radrajith/ESE-495_Laser_arduino/pcb_layout_ESE495.docx

Schematic

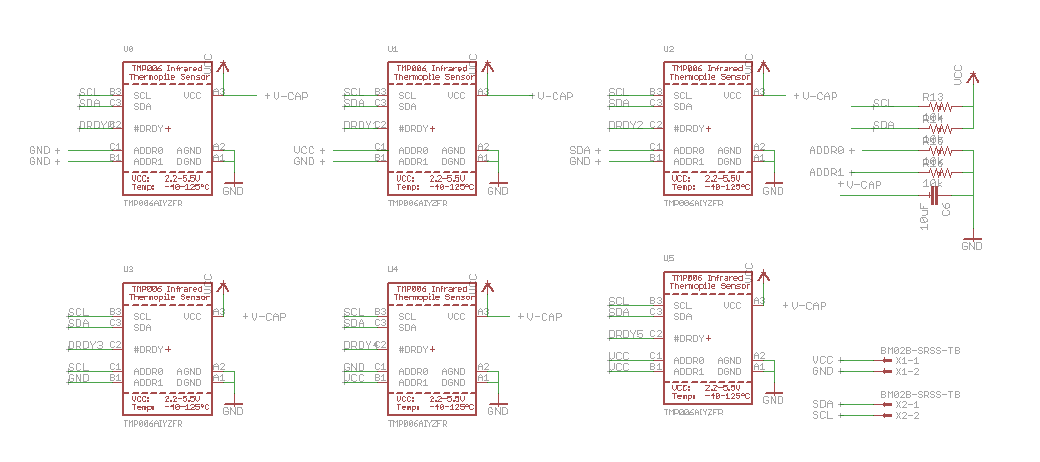
[picture p18: figure]

Front back

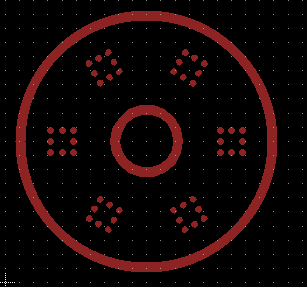
[picture p19: figure]
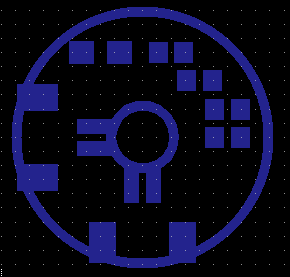
[picture p20: figure]
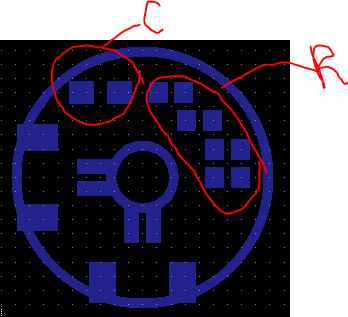
[picture p21: figure]

Outer Diameter – 0.450 inches or 11.43 mm

Inner diameter – 0.1 inches or 2.54mm

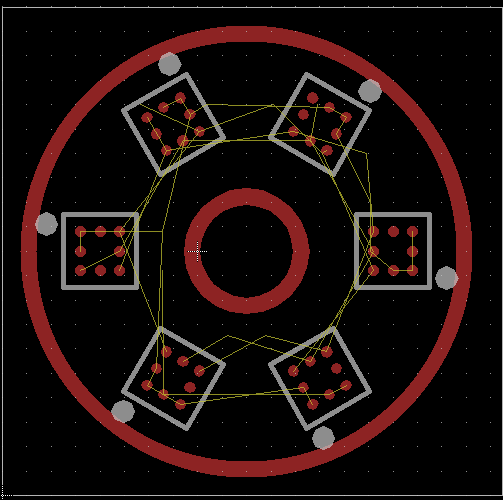
[picture p22: figure]
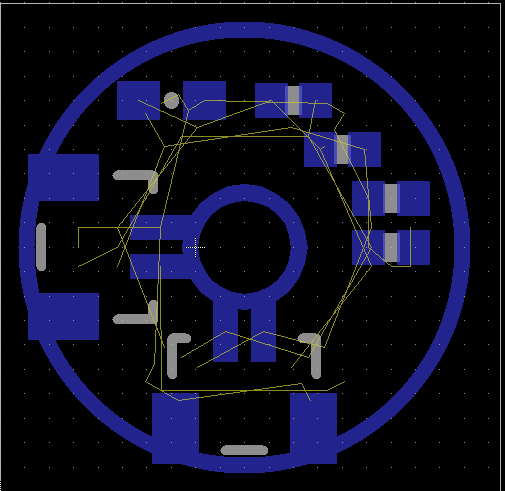
[picture p23: figure]
