radrajith/ESE-495_Laser_arduino/circuit simulations.docx

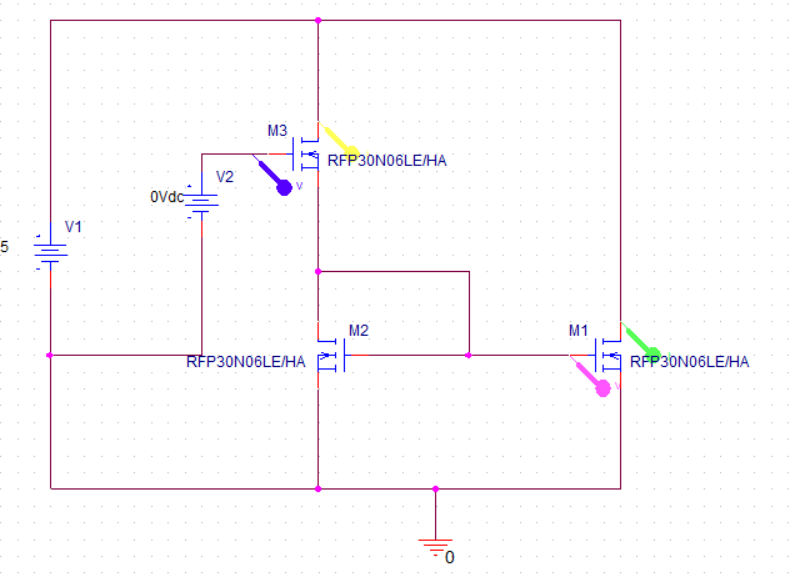
[picture p49: figure]
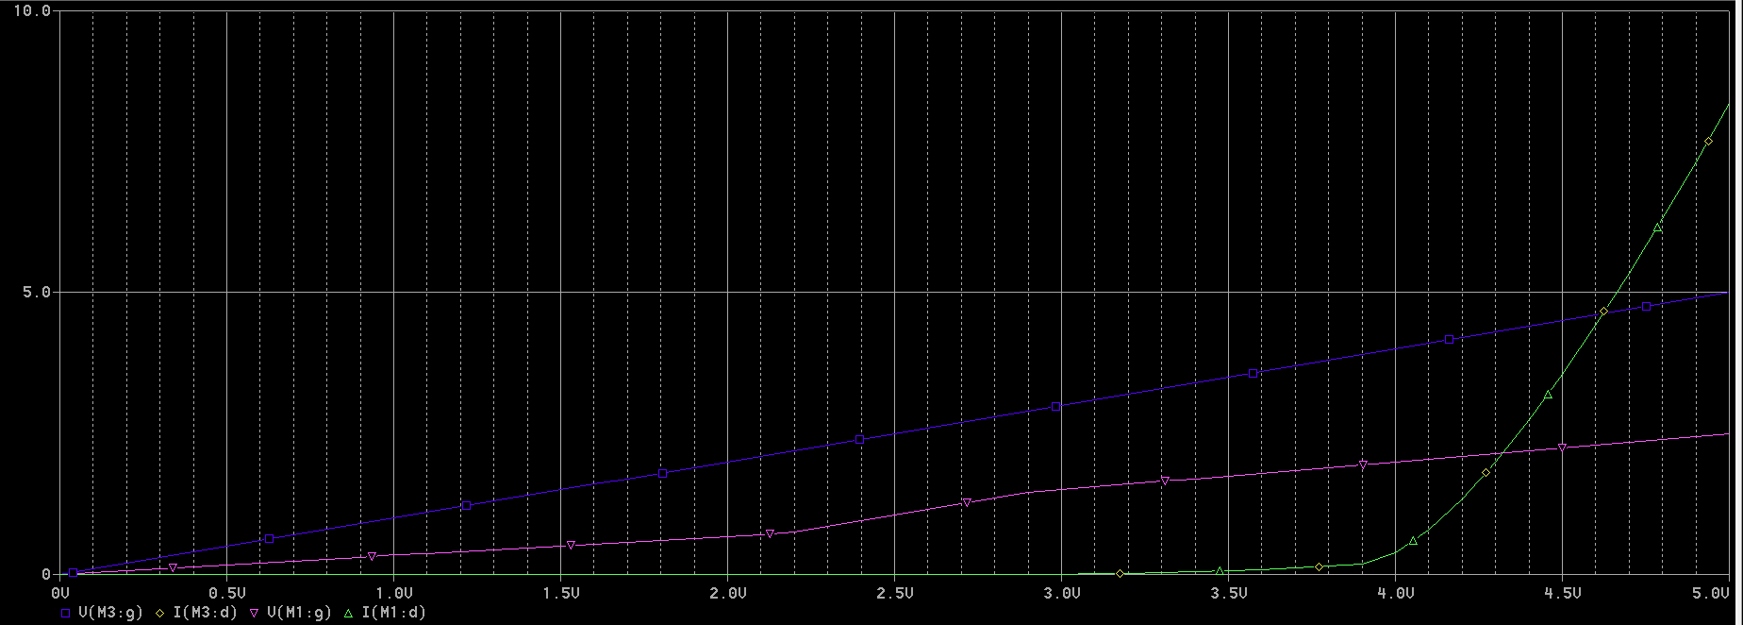
[picture p50: figure]
