radrajith/ESE-495_Laser_arduino/absoption spectra of different skin constituents.png

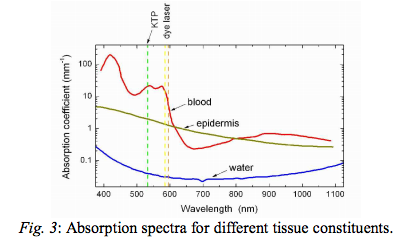
absoption spectra of different skin constituents.png
