radrajith/ESE-495_Laser_arduino/laser PS simulations/linear schemati.PNG

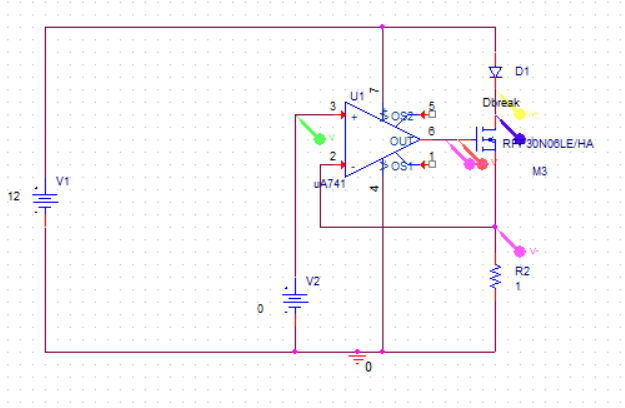
laser PS simulations/linear schemati.PNG
