radrajith/ESE-495_Laser_arduino/laser PS simulations/linear sim.PNG

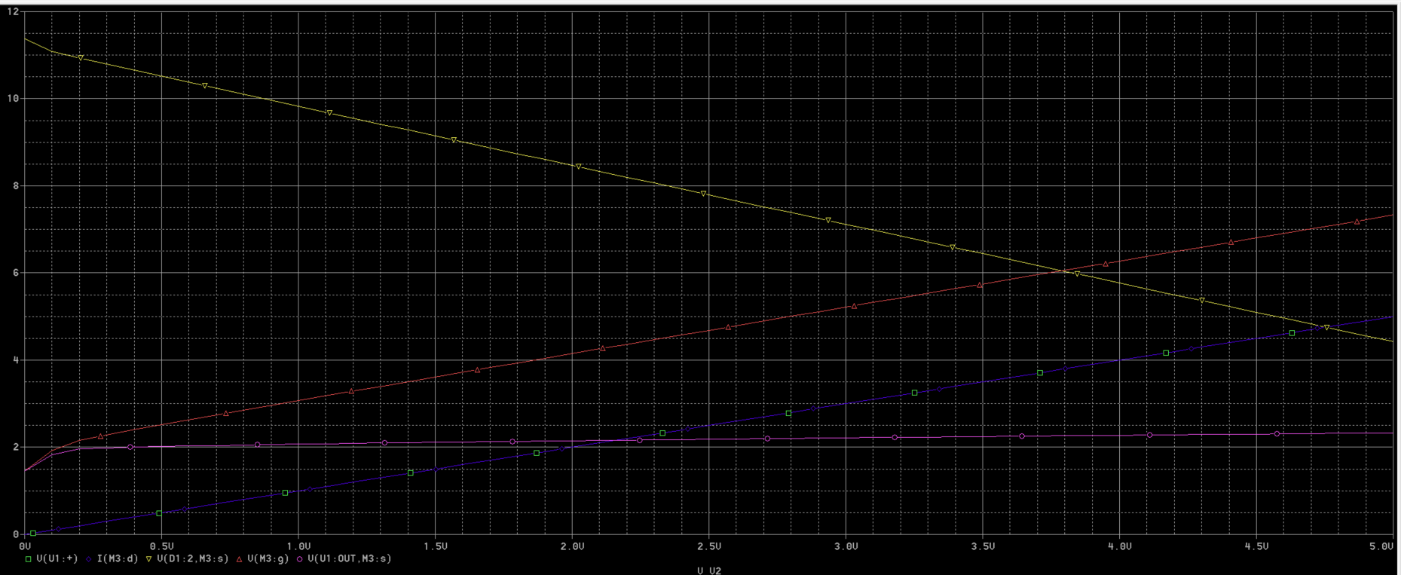
laser PS simulations/linear sim.PNG
