radrajith/ESE-495_Laser_arduino/laser PS simulations/sine wave schematic.PNG

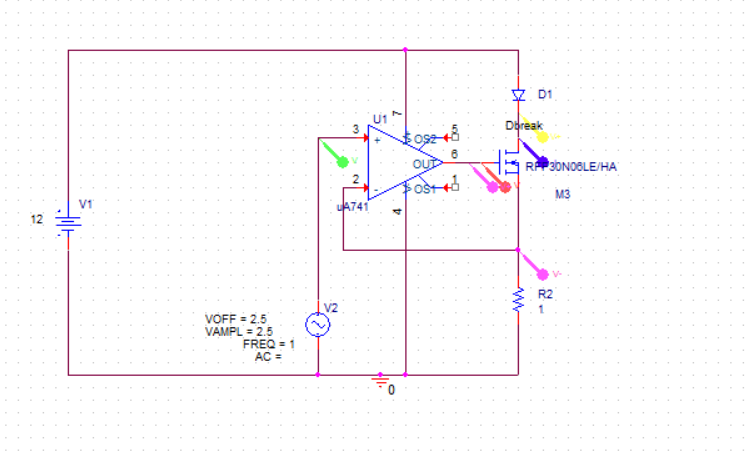
laser PS simulations/sine wave schematic.PNG
