radrajith/ESE-495_Laser_arduino/laser PS simulations/sine wave.PNG

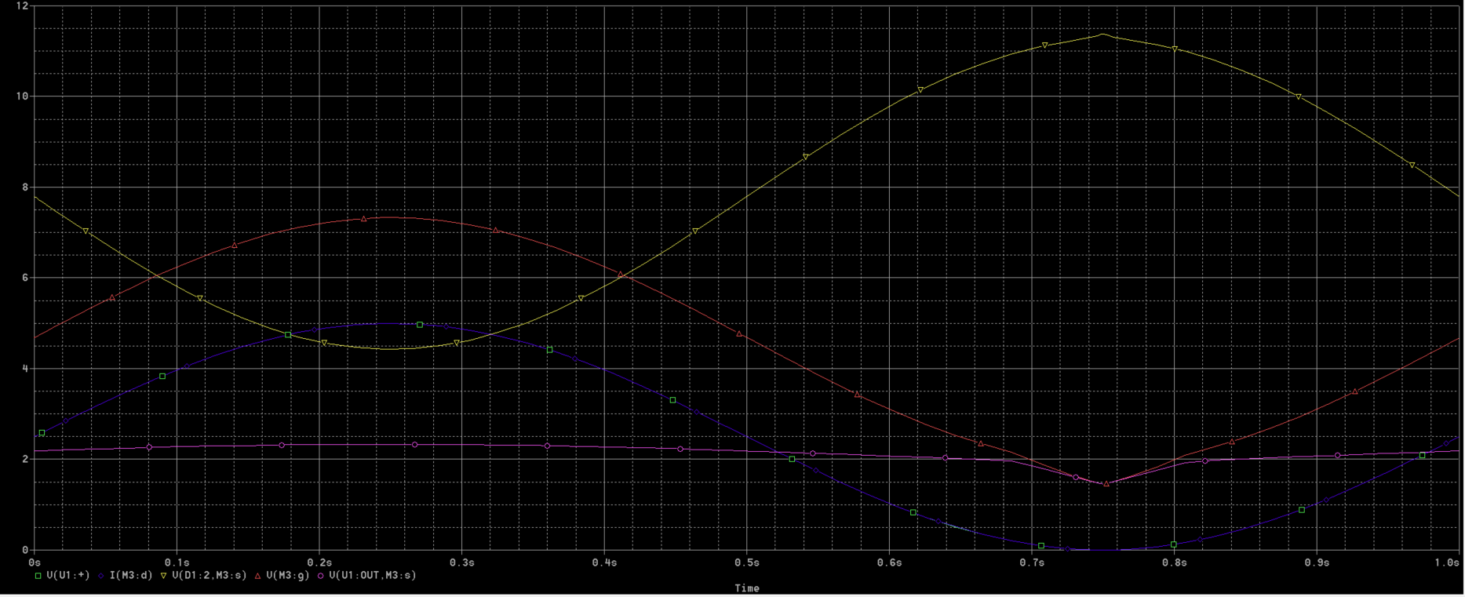
laser PS simulations/sine wave.PNG
