radrajith/ESE-495_Laser_arduino/(list of files, cad)

Other CAD files:
object image.dwg
