radrajith/ESE-495_Laser_arduino/Pspice model/test1.pdf

Date/Time run: 01/13/17 20:32:57

** Profile: "SCHEMATIC1-test1" | [ c:\users\radra\box sync\senior fall 2016\ese 440\circuit simulation 1\... Temperature: 27.0

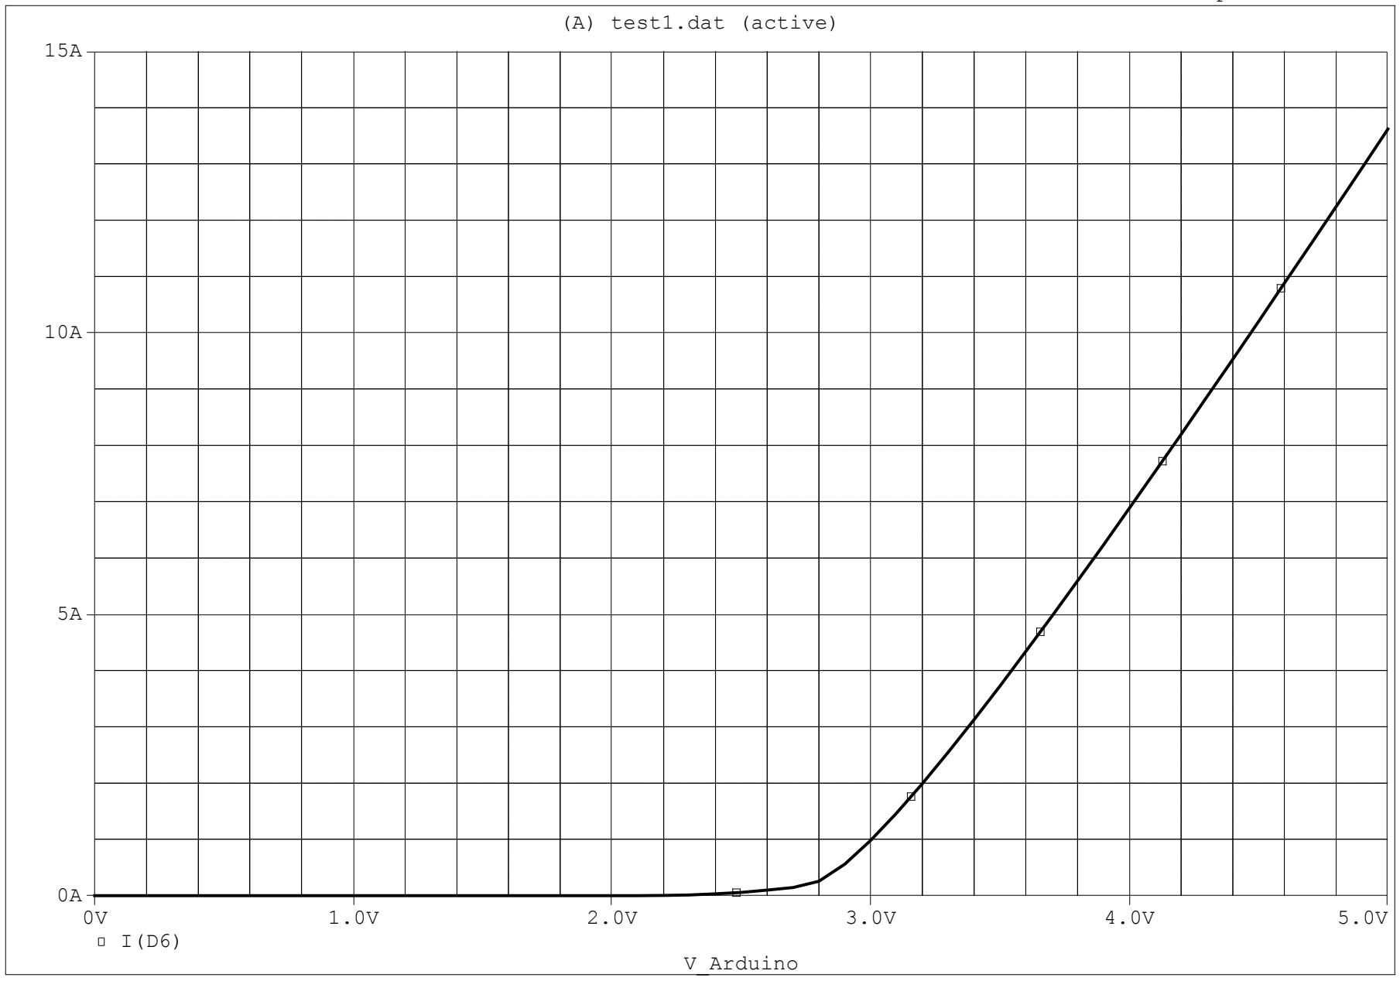
[picture p56: figure]
(A) test1.dat (active); V_Arduino

Date: January 13, 2017 | Page 1 | Time: 20:34:19
