radrajith/ESE-495_Laser_arduino/ESE 499 laser characteristics.xlsx

Sheet: Sheet1
Voltage (mV) | Current (mA) | Power(mW) | Actual voltage(mV) | Voltage across Vds
0 | 0 | 0
1664 | 100 | 0.11 | 1586
1787 | 200 | 0.24 | 1630
1898 | 300 | 0.41 | 1664
2000 | 400 | 0.63 | 1692
2115 | 500 | 0.97 | 1717
2233 | 600 | 1.44 | 1740 |  |  |  | 1 | 1
2338 | 700 | 2.21 | 1762 |  |  |  | 2 | 1.644
2443 | 800 | 4.01 | 1781 |  |  |  | 3 | 1.74
2536 | 900 | 32 | 1800 |  |  |  | 3.5 | 1.768 | Resistance | 0.943K
2598 | 950 | 90.1 |  |  |  |  | 3.995 | 1.793
2613 | 960 | 97
2625 | 970 | 118
2633 | 980 | 123 |  |  | Resistance (ohms)
2636 | 990 | 134 |  |  | 1.36
2643 | 1000 | 152.2 | 1821
2655 | 1010 | 159.5
2666 | 1020 | 183.4
2670 | 1030 | 184.6
2682 | 1040 | 193.2 |  |  | 1.9W max
2695 | 1050 | 200
2700 | 1060 | 243.8
2820 | 1070 | 250.6
2850 | 1080 | 267
2880 | 1090 | 276.3
2900 | 1100 | 303.3 | 1841 | 0.074
2910 | 1110 | 305
2930 | 1120 | 311.7
2950 | 1130 | 336
2960 | 1140 | 346.4
2970 | 1150 | 359.3
3040 | 1200 | 424.9 | 1860
3100 | 1250 | 483.6
3170 | 1300 | 548.1 | 1879
3226 | 1350 | 607.2
3289 | 1400 | 677.8 | 1898
3410 | 1450 | 763.4
3460 | 1500 | 824.2 | 1917
3540 | 1550 | 887.9
3630 | 1600 | 954.2 | 1936
3689 | 1650 | 1007
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
