radrajith/ESE-495_Laser_arduino/laser_test_circuit.jpg

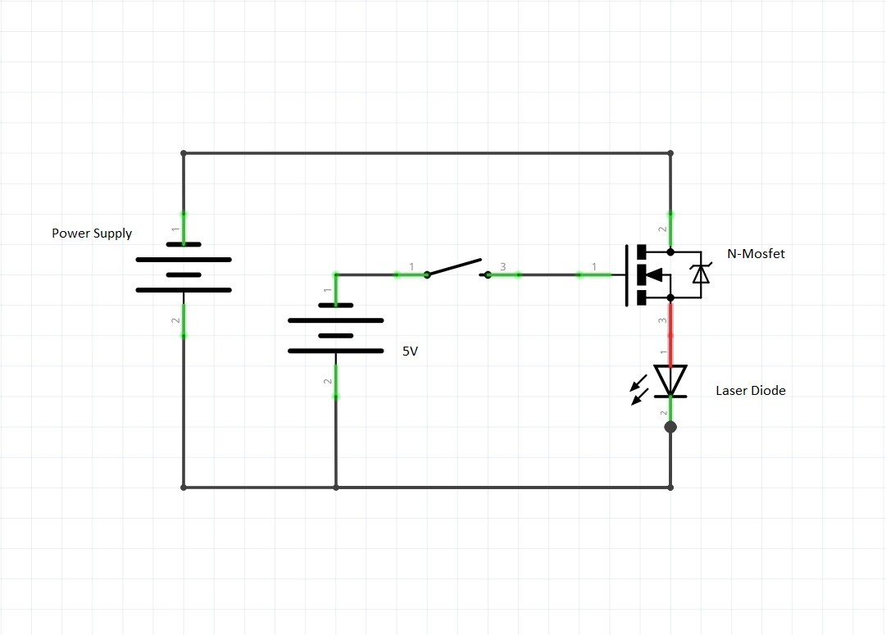
laser_test_circuit.jpg
