radrajith/ESE-495_Laser_arduino/Pspice model/test3.pdf

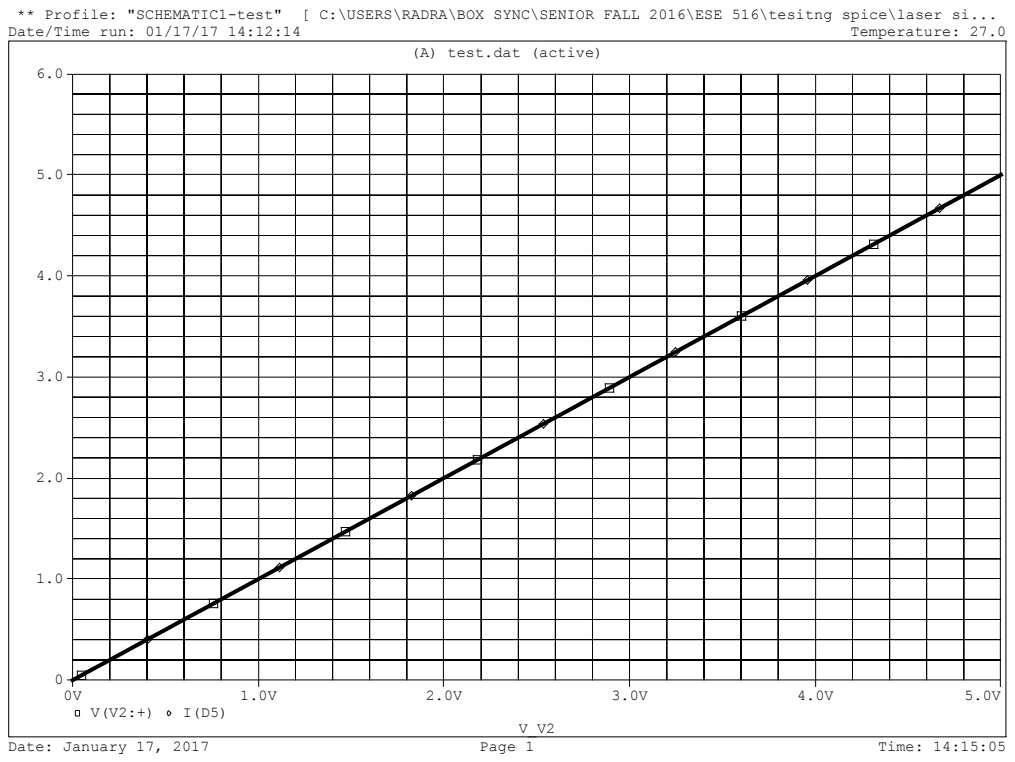
[picture p58: page 1]
** Profile: "SCHEMATIC1-test"; [ C:\USERS\RADRA\BOX SYNC\SENIOR FALL 2016\ESE 516\tesitng spice\laser si...; Temperature: 27.0; Date: January 17, 2017; Page 1; Time: 14:15:05

Date/Time run: 01/17/17 14:12:14

(A) test.dat (active)
