radrajith/ESE-495_Laser_arduino/Pspice model/test.pdf

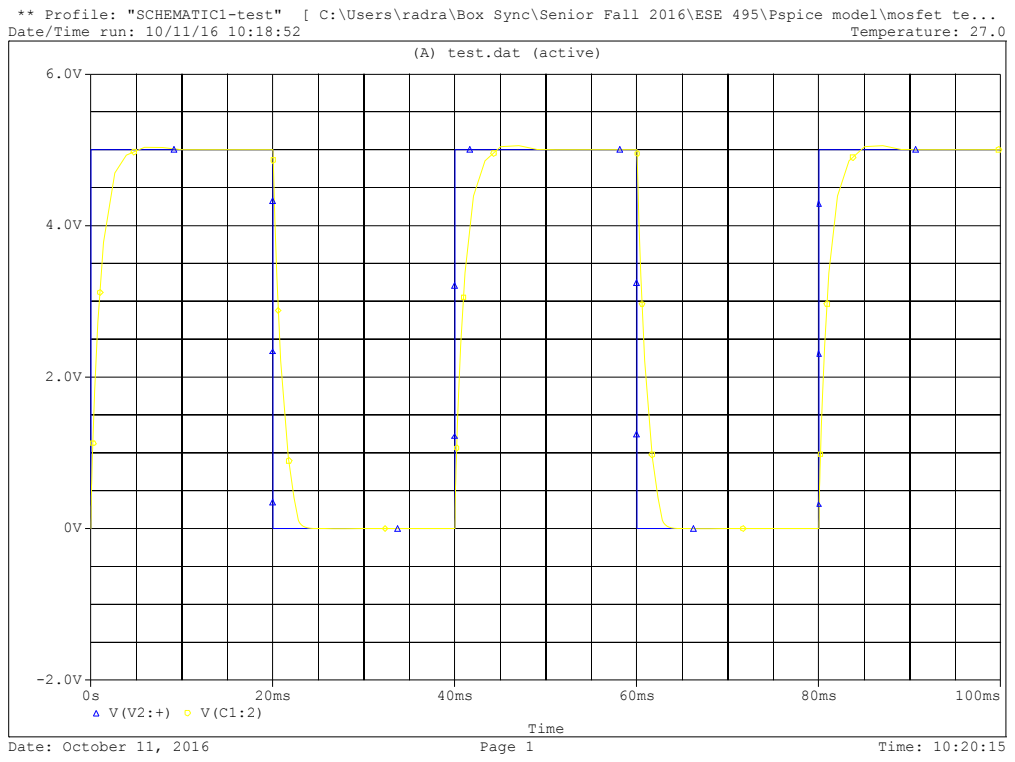
[picture p59: page 1]
** Profile: "SCHEMATIC1-test"; [ C:\Users\radra\Box Sync\Senior Fall 2016\ESE 495\Pspice model\mosfet te...; Temperature: 27.0; Date: October 11, 2016; Page 1; Time: 10:20:15; Time

Date/Time run: 10/11/16 10:18:52

(A) test.dat (active)
