radrajith/ESE-495_Laser_arduino/object image.pdf

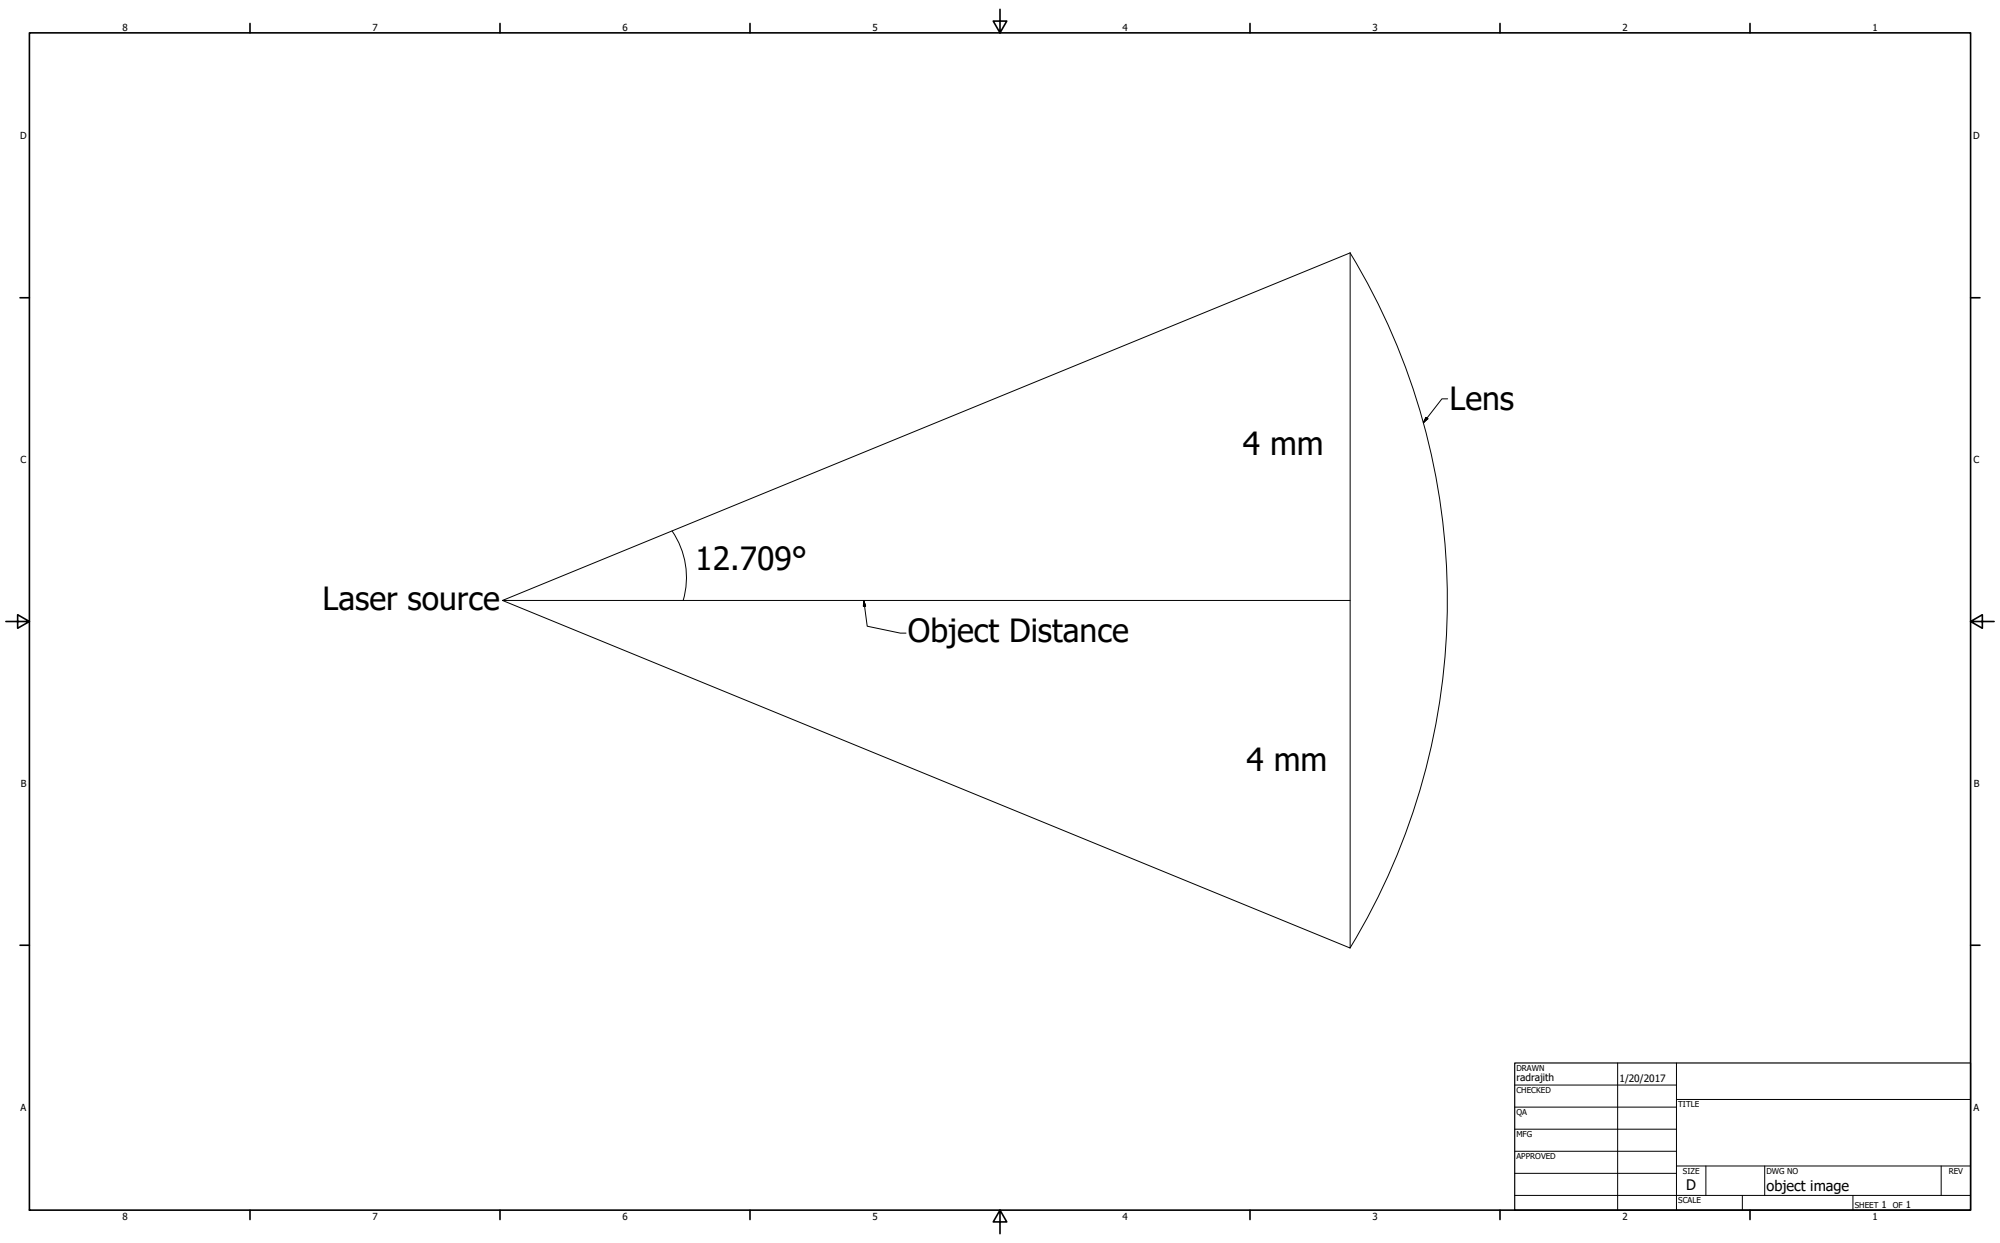
[picture p60: page 1]
SHEET 1 OF 1; DRAWN; CHECKED; MFG; APPROVED; radrajith; DWG NO object image; TITLE; SIZE D; SCALE; REV; Object Distance; Lens; Laser source
