radrajith/ESE-495_Laser_arduino/Pspice model/SCHEMATIC1 _ PAGE1.pdf

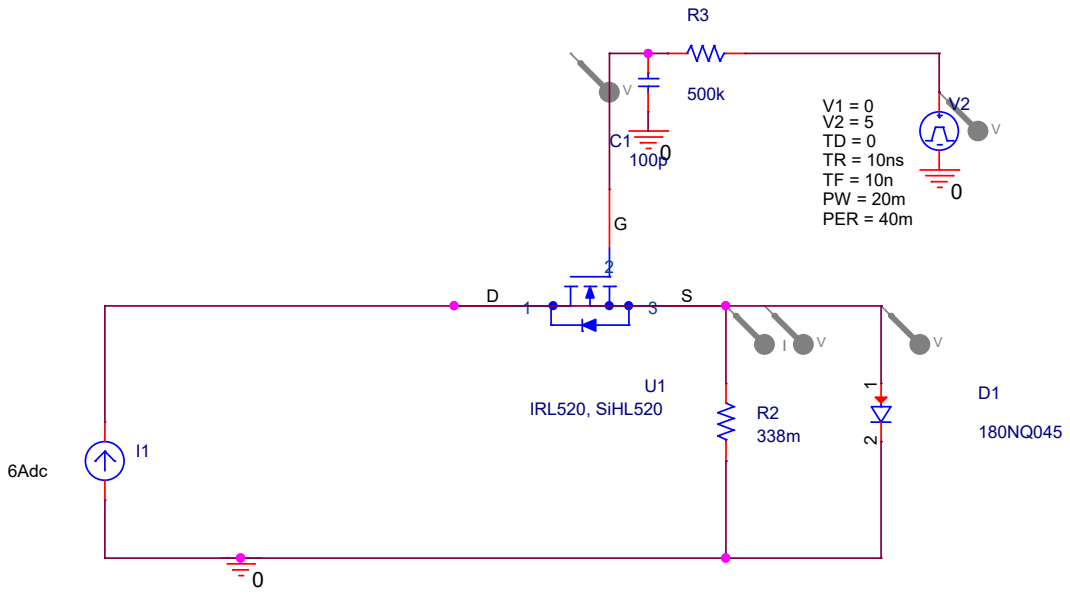
[picture p61: page 1]
Title; Size; Document Number; Rev; Date:; Sheet; <Doc>; <RevCode>; <Title>; Tuesday, October 11, 2016; TF = 10n PW = 20m PER = 40m; U1 IRL520, SiHL520; 6Adc
