radrajith/ESE-495_Laser_arduino/(list of files, drawings)

Other design files:
Pspice model/DESIGN1.DSN
Pspice model/Design1.opj
Pspice model/LIBRARY1.OLB
Pspice model/MOSFET TEST.DSN
Pspice model/mosfet test.opj
