radrajith/ESE-495_Laser_arduino/Eagle files/Temp sensor/tempSensorV1.brd

## EAGLE design Eagle files/Temp sensor/tempSensorV1.brd (2016-09-04)

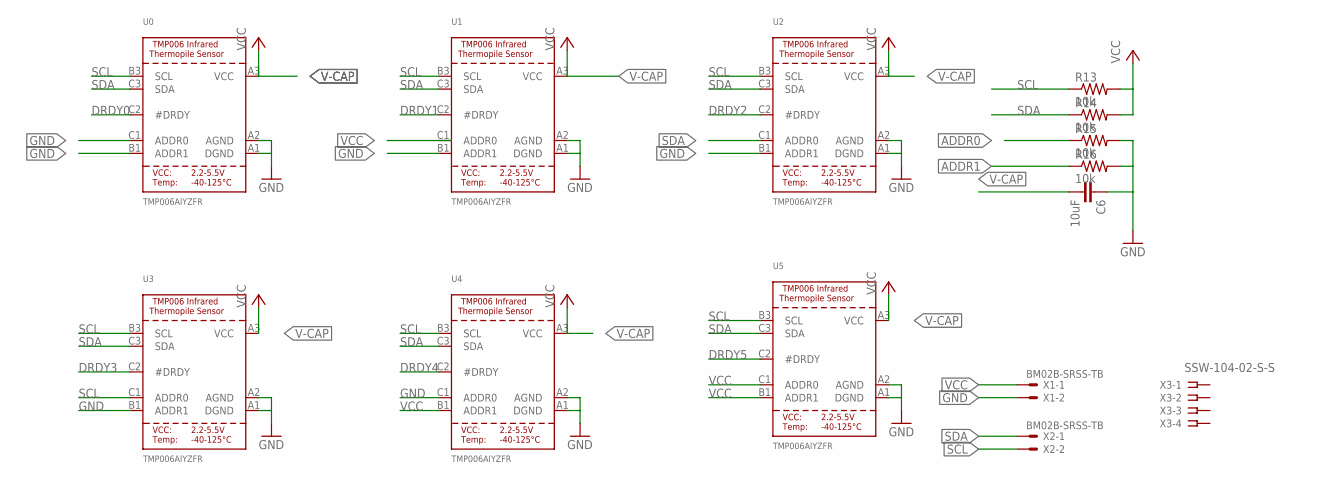
[picture p62: schematic tempSensorV1.sch]

Parts:
C6: 10uF; 0603-CAP
R13, R14, R15, R16: 10k; 0402-RES
U0, U1, U2, U3, U4, U5: TMP006AIYZFR; WCSP-8
X1, X2: BM02B-SRSS-TB
X3: SSW-104-02-S-S

Connections:
ADDR0: R15.1
ADDR1: R16.1
DRDY0: U0.C2 (#DRDY)
DRDY1: U1.C2 (#DRDY)
DRDY2: U2.C2 (#DRDY)
DRDY3: U3.C2 (#DRDY)
DRDY4: U4.C2 (#DRDY)
DRDY5: U5.C2 (#DRDY)
GND: C6.1, R15.2, R16.2, U0.A1 (DGND), U0.A2 (AGND), U0.B1 (ADDR1), U0.C1 (ADDR0), U1.A1 (DGND), U1.A2 (AGND), U1.B1 (ADDR1), U2.A1 (DGND), U2.A2 (AGND), U2.B1 (ADDR1), U3.A1 (DGND), U3.A2 (AGND), U3.B1 (ADDR1), U4.A1 (DGND), U4.A2 (AGND), U4.C1 (ADDR0), U5.A1 (DGND), U5.A2 (AGND), X1.2
SCL: R13.1, U0.B3 (SCL), U1.B3 (SCL), U2.B3 (SCL), U3.B3 (SCL), U3.C1 (ADDR0), U4.B3 (SCL), U5.B3 (SCL), X2.2
SDA: R14.1, U0.C3 (SDA), U1.C3 (SDA), U2.C1 (ADDR0), U2.C3 (SDA), U3.C3 (SDA), U4.C3 (SDA), U5.C3 (SDA), X2.1
V-CAP: C6.2, R13.2, R14.2, U0.A3 (VCC), U1.A3 (VCC), U2.A3 (VCC), U3.A3 (VCC), U4.A3 (VCC), U5.A3 (VCC)
VCC: U4.B1 (ADDR1), U5.B1 (ADDR1), U5.C1 (ADDR0), X1.1

Board: 2 copper layers, 14 parts (7 on the bottom side), 5 nets, no tracks yet.
