radrajith/ESE-495_Laser_arduino/Adafruit-TMP006-and-TMP007-PCB-master/TMP006.brd

## EAGLE design Adafruit-TMP006-and-TMP007-PCB-master/TMP006.brd (2016-09-04)

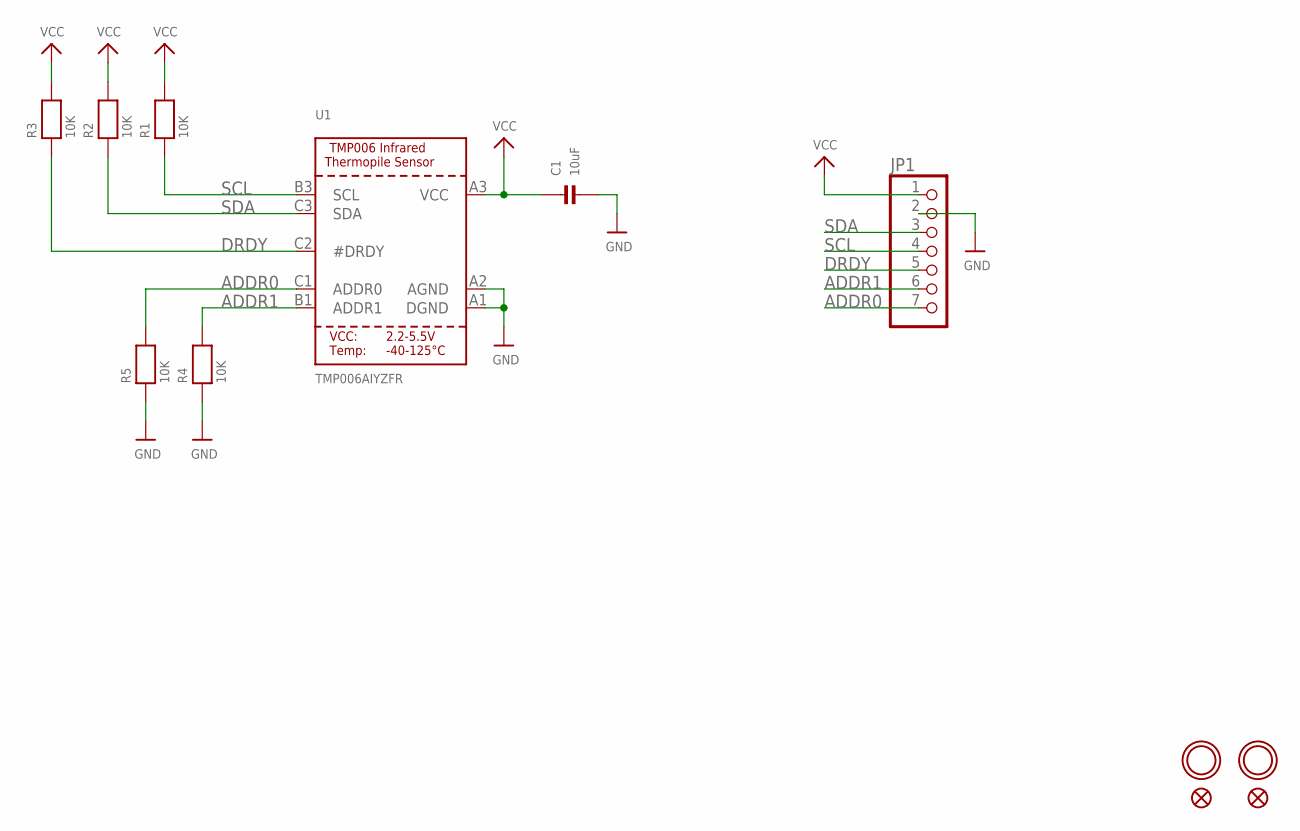
[picture p63: schematic TMP006.sch]

Parts:
C1: 10uF; 0805
FID1, FID2: FIDUCIAL""; FIDUCIAL_1MM
JP1: HEADER-1X7THICKER; 1X07_ROUND_76
R1, R2, R3, R4, R5: 10K; 0805
U1: TMP006AIYZFR; WCSP-8
U$6, U$7: MOUNTINGHOLE2.5; MOUNTINGHOLE_2.5_PLATED

Connections:
ADDR0: JP1.7, R5.2, U1.C1 (ADDR0)
ADDR1: JP1.6, R4.2, U1.B1 (ADDR1)
DRDY: JP1.5, R3.1, U1.C2 (#DRDY)
GND: C1.2, JP1.2, R4.1, R5.1, U1.A1 (DGND), U1.A2 (AGND)
SCL: JP1.4, R1.1, U1.B3 (SCL)
SDA: JP1.3, R2.1, U1.C3 (SDA)
VCC: C1.1, JP1.1, R1.2, R2.2, R3.2, U1.A3 (VCC)

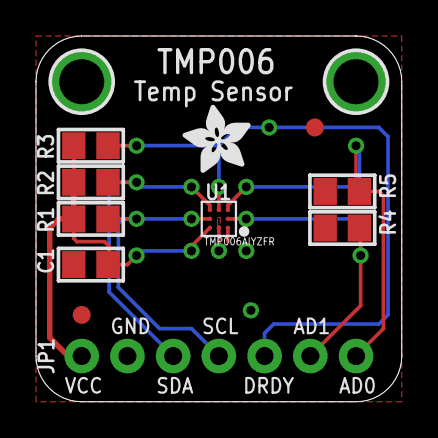
[picture p64: board TMP006.brd from above]

Board: 2 copper layers, 20.3 x 20.3 mm, 13 parts (0 on the bottom side), 7 nets.

Other parts of the board:
U$9: ADAFRUIT_3.5MM
