radrajith/ESE-495_Laser_arduino/(commit log)

2016-09-04 uploading all the files used for reserach
    ESE 495 research project - laser to treat skin lesions.
    [TMP006 trial run with resistors heating.xlsx, TMP006.brd, TMP006.sch, power graphs.xlsx, tempSensorV1.brd, tempSensorV1.sch, tmp006 trial run with water.xlsx]
2016-10-13 pspice test-still not completed
    [DESIGN1.DSN, Design1.opj, LIBRARY1.OLB, MLX90615_TEMPDATA_9_19_16.xlsx, MOSFET TEST.DSN, mosfet test.opj]
2016-11-06 took data and added some files and pic
    [ESE 499 laser characteristics.xlsx, MLX90615_TEMPDATA_9_19_16.xlsx]
2016-11-20 created sqwave library and changed arduino code to include that and test it
    [ESE 499 laser characteristics.xlsx]
2017-01-14 in the process of writing/modifying research paper
    [ESE 499 laser characteristics.xlsx, PCB.sch, tempSensorV1.brd, tempSensorV1.sch]
2017-02-03 update matlab code
    [ESE 499 laser characteristics.xlsx, object image.dwg]
